JR3XNW/pico-SDR/BandScope_128x32/Wiring Diagram.jpg

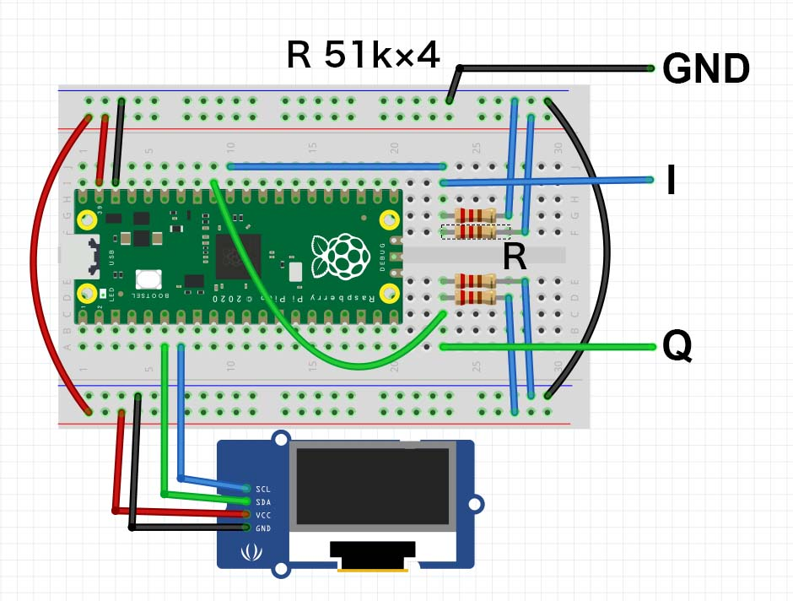
BandScope_128x32/Wiring Diagram.jpg
