JR3XNW/pico-SDR/uSDX/uSDX_1.02.jpg

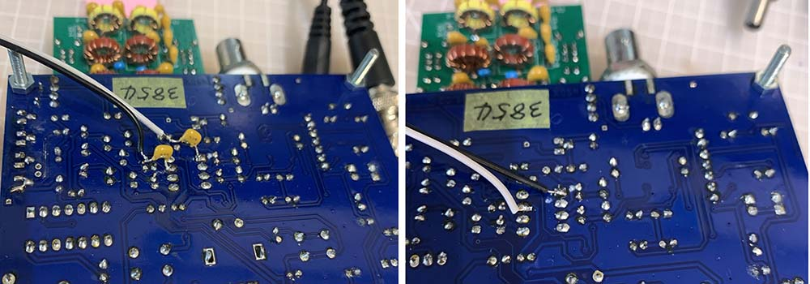
uSDX/uSDX_1.02.jpg
