JR3XNW/pico-SDR/BandScope_128x32/BlockDiagram.jpg

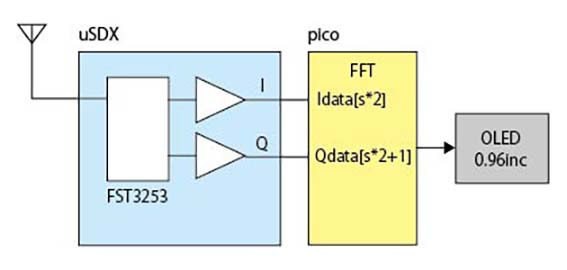
BandScope_128x32/BlockDiagram.jpg
