JR3XNW/pico-SDR/BandScope_128x32/pico_BandScope_128x32_circuit.jpg

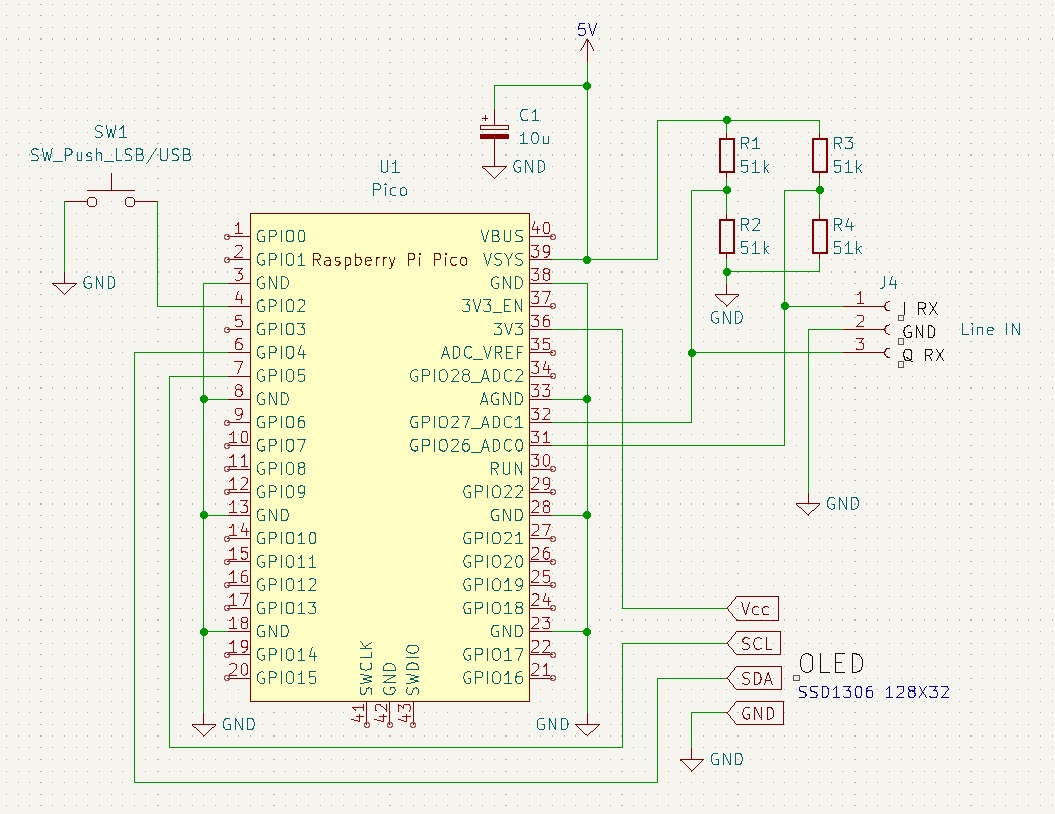
BandScope_128x32/pico_BandScope_128x32_circuit.jpg
