JR3XNW/pico-SDR/BandScope_WaterFal128x64/pico_FFT_circuit.jpg

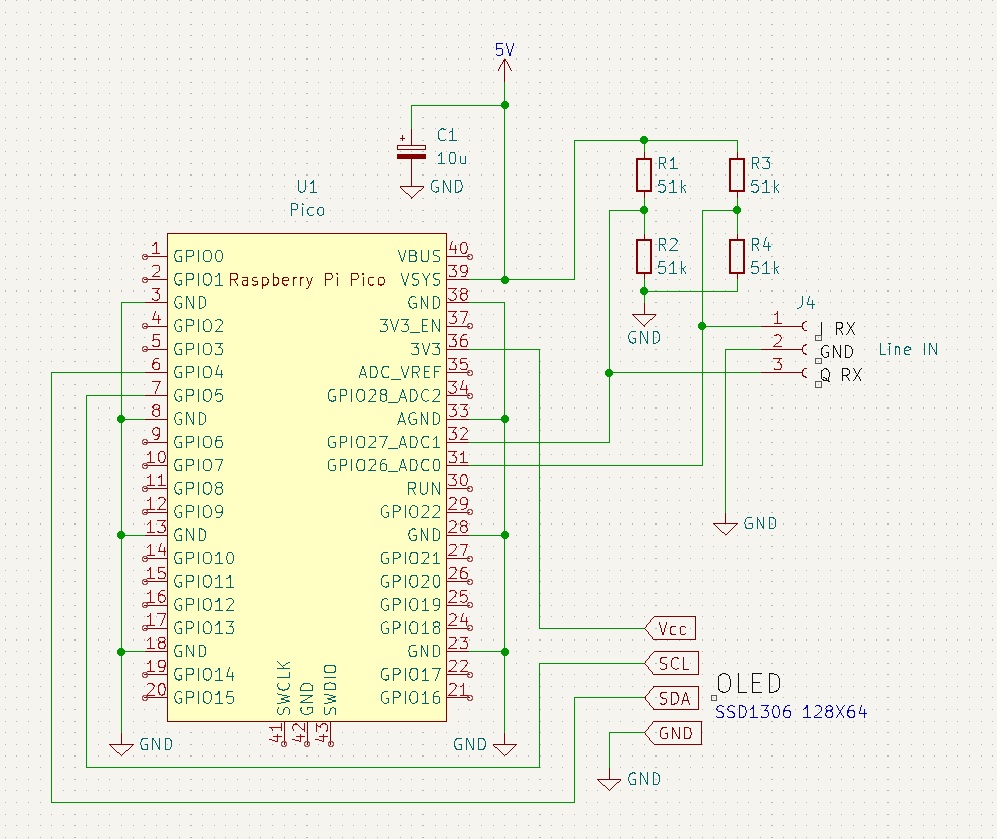
BandScope_WaterFal128x64/pico_FFT_circuit.jpg
