JR3XNW/pico-SDR/pico40M_monoband_radio/MixerCircuit.jpg

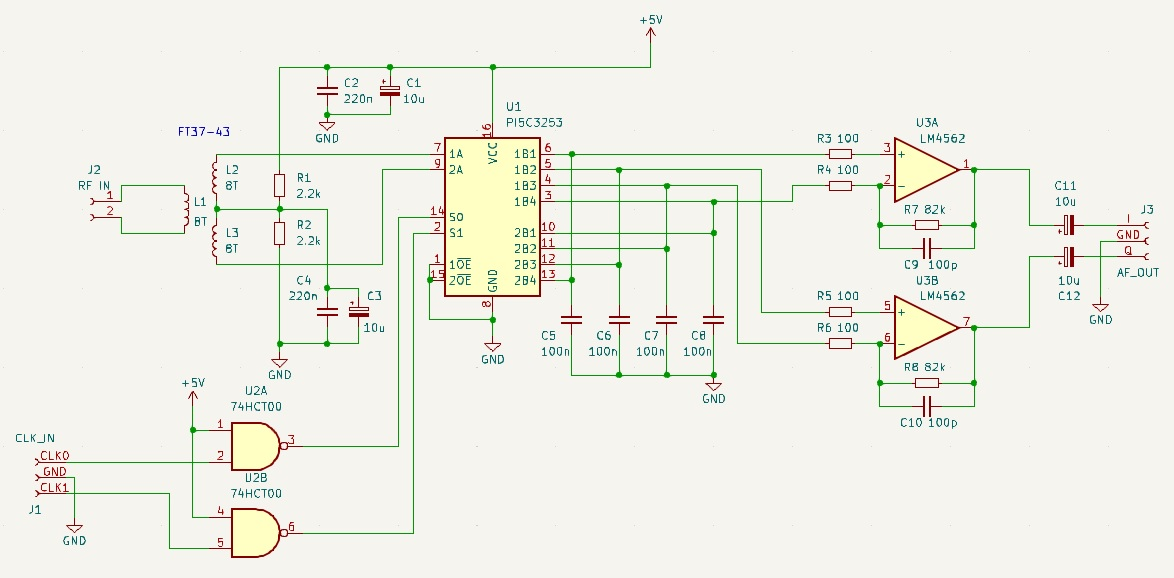
pico40M_monoband_radio/MixerCircuit.jpg
