JR3XNW/pico-SDR/pico40M_monoband_radio/pico_SDR.jpg

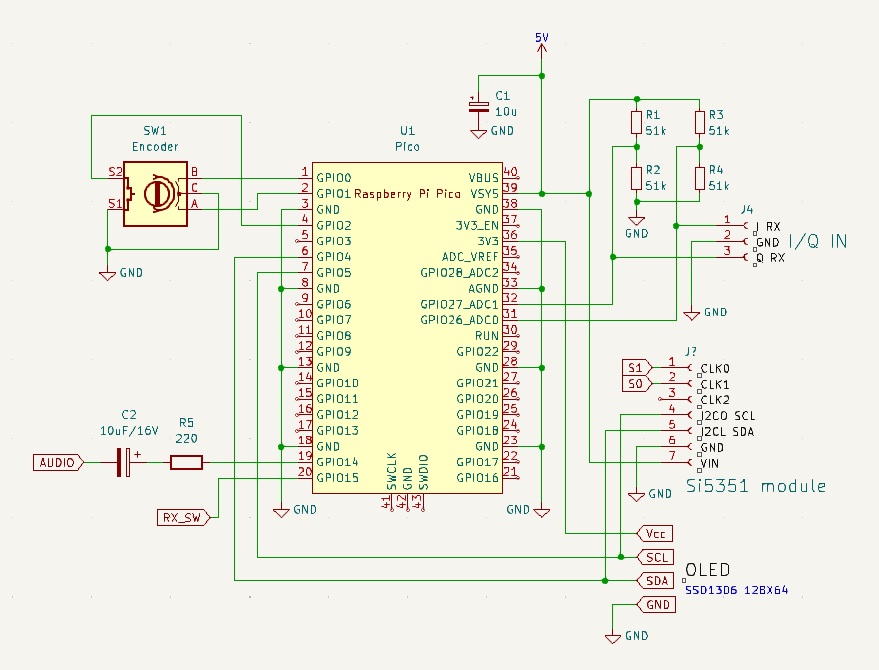
pico40M_monoband_radio/pico_SDR.jpg
