JR3XNW/pico-SDR/pico40M_monoband_uSDX/Atmega328_to_pico.jpg

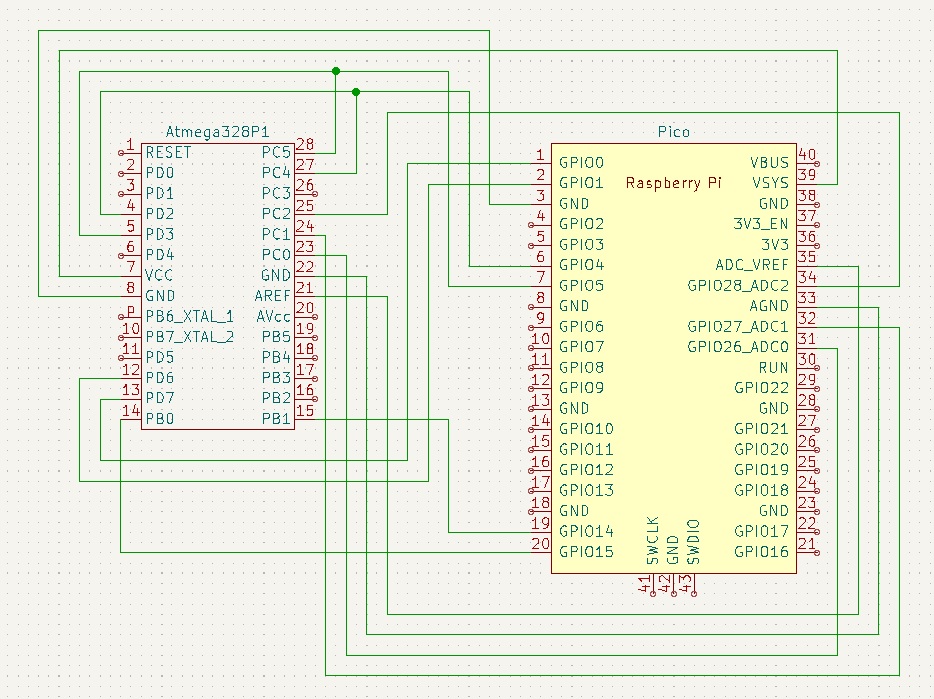
pico40M_monoband_uSDX/Atmega328_to_pico.jpg
