JR3XNW/pico-SDR/pico40M_monoband_uSDX/change_sketches.jpg

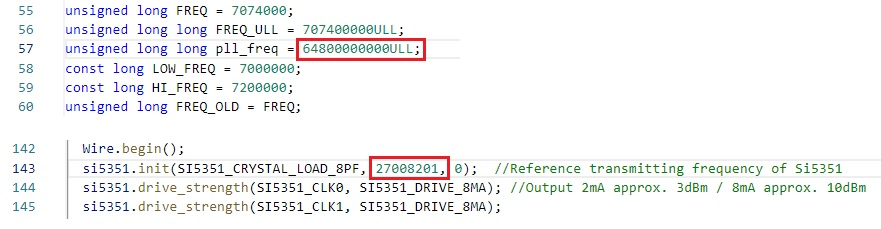
pico40M_monoband_uSDX/change_sketches.jpg
