JR3XNW/pico-SDR/pico40M_monoband_uSDX/image6.jpeg

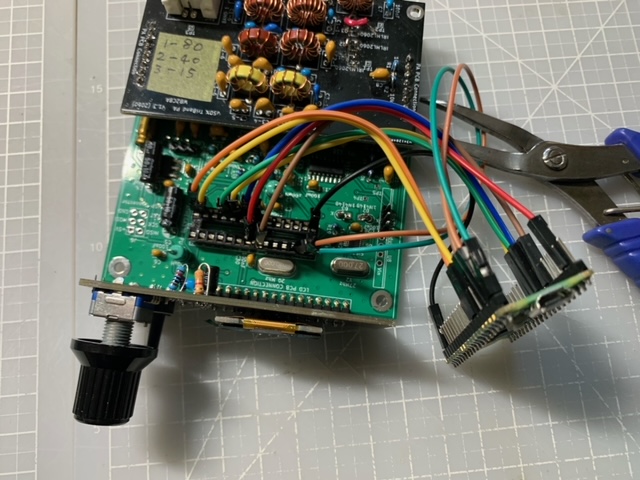
pico40M_monoband_uSDX/image6.jpeg
