JR3XNW/pico-SDR/pico40M_monoband_uSDX/uSDX_TriBand.jpg

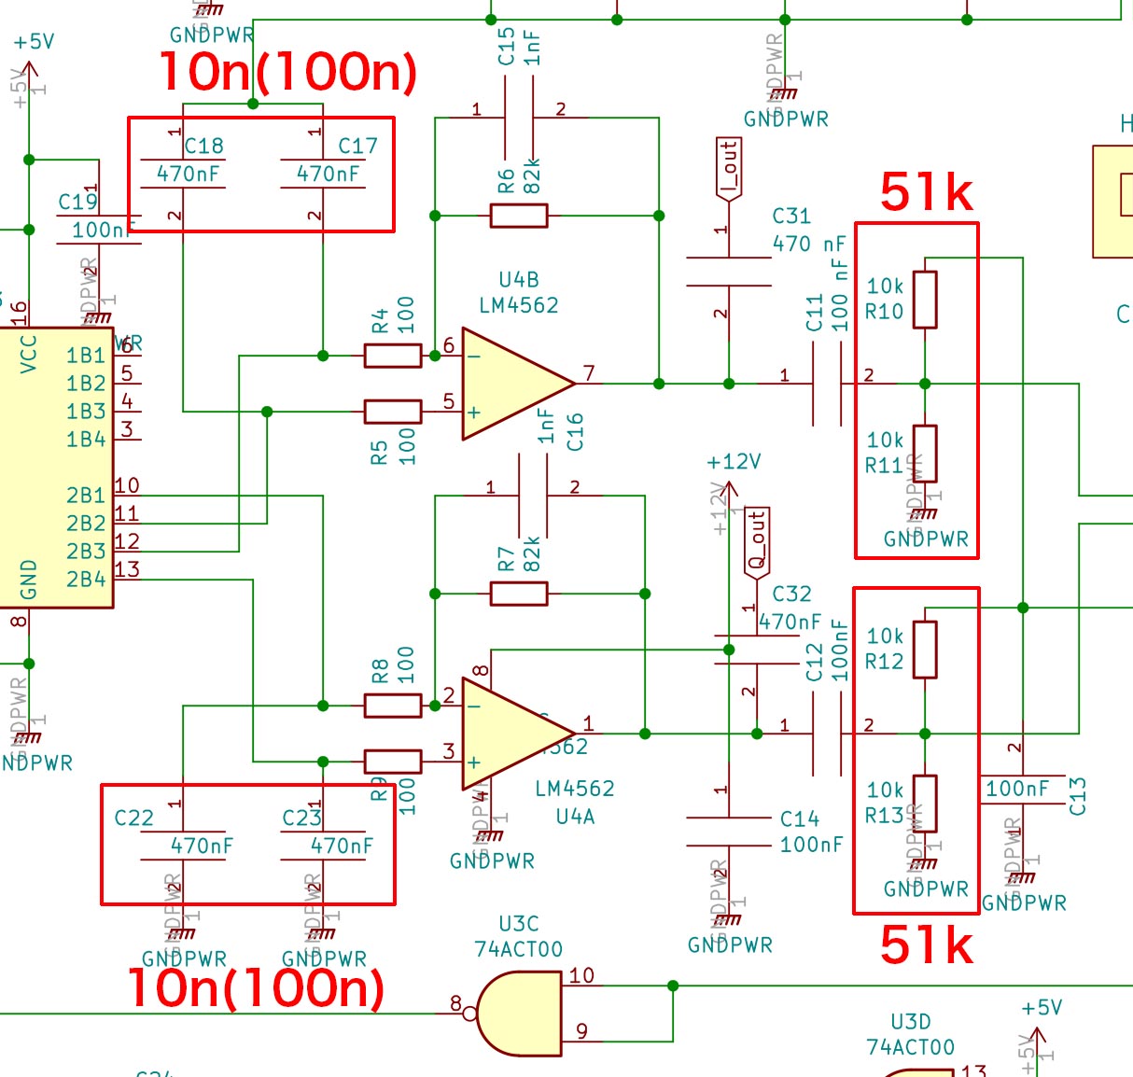
pico40M_monoband_uSDX/uSDX_TriBand.jpg
