JR3XNW/pico-SDR/Seeed_XIAO_RP2040_SDR_Radio/circuit.jpg

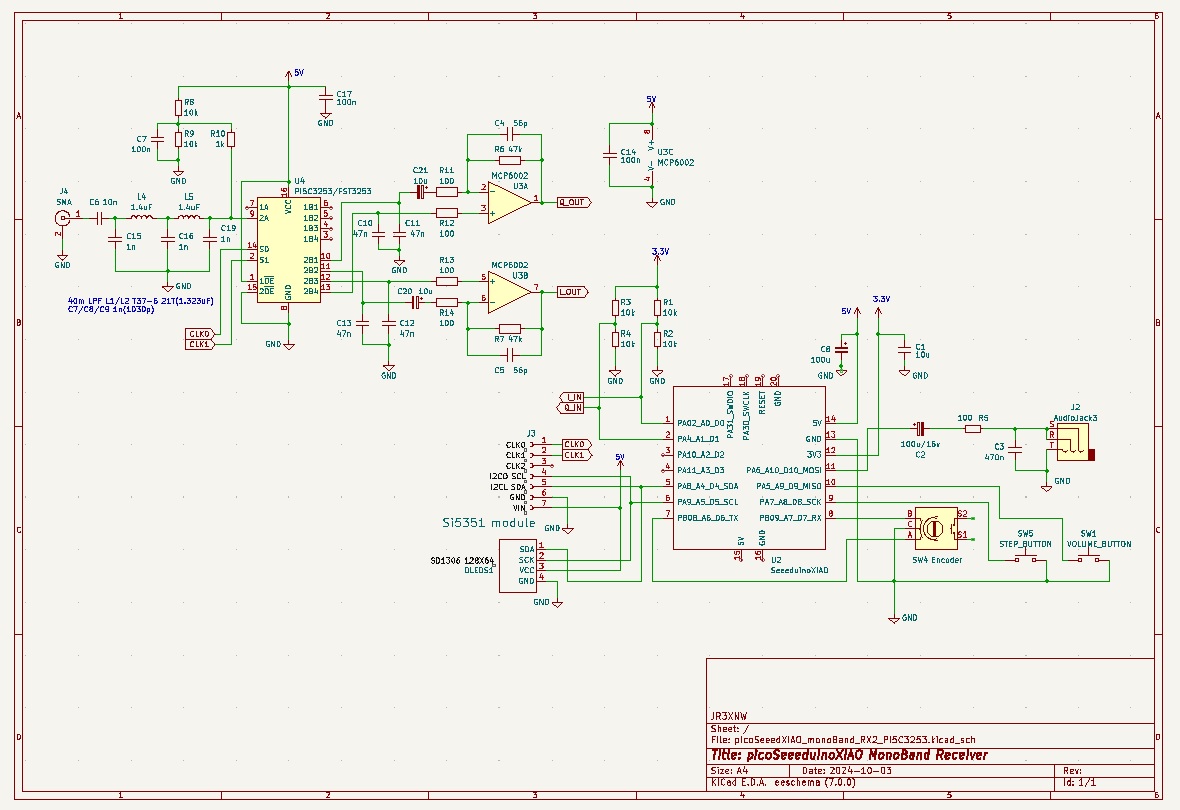
Seeed_XIAO_RP2040_SDR_Radio/circuit.jpg
