JR3XNW/pico-SDR/uSDX/uSDX_TriBand.jpg

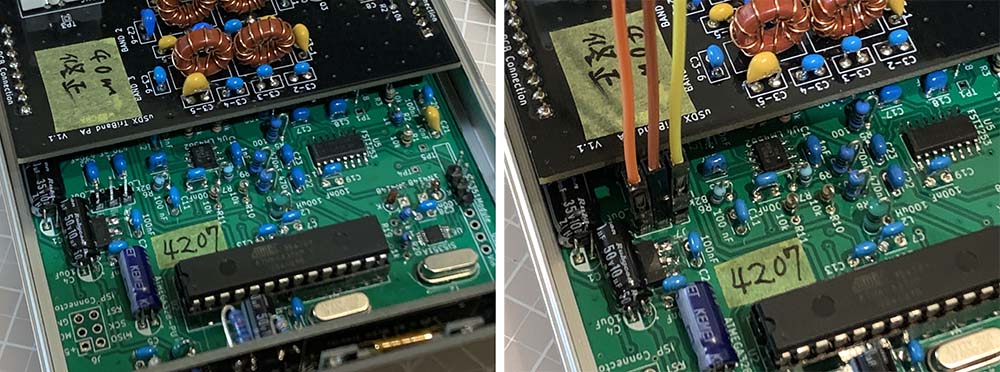
uSDX/uSDX_TriBand.jpg
