JR3XNW/pico-SDR/VFO_BandScope/pico_uSDX_VFO_BandScrope.jpeg

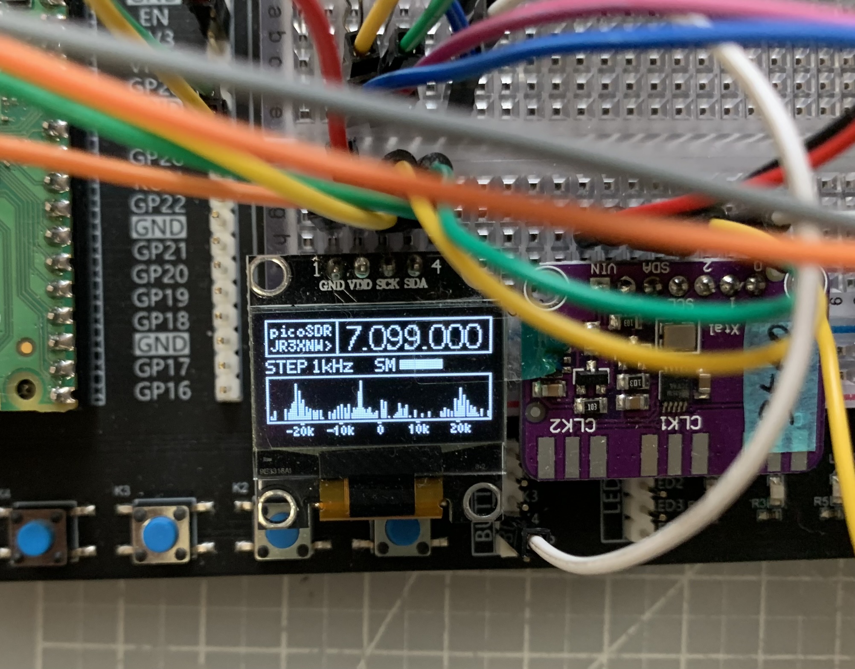
VFO_BandScope/pico_uSDX_VFO_BandScrope.jpeg
