JR3XNW/pico-SDR/VFO_BandScope/pico_uSDX_VFO_FFT_04_24.jpg

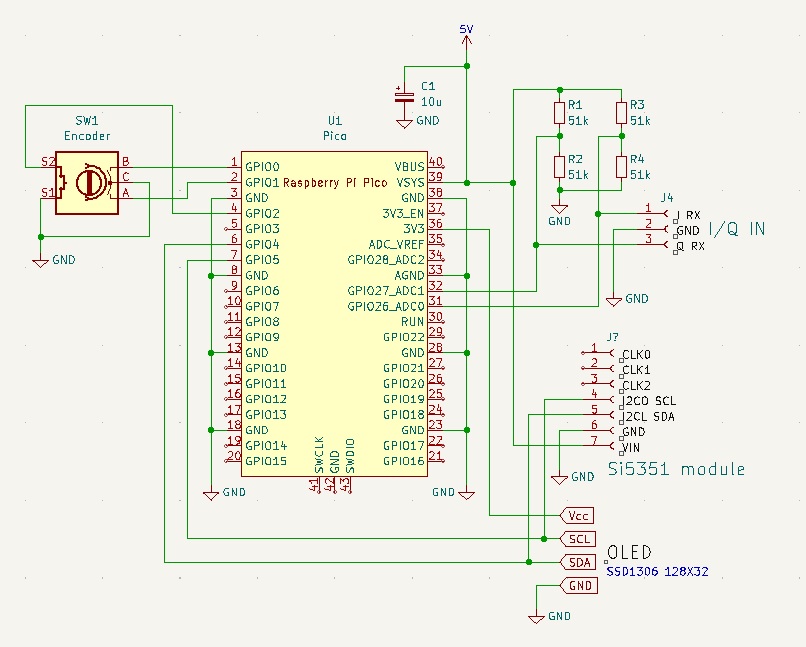
VFO_BandScope/pico_uSDX_VFO_FFT_04_24.jpg
