JR3XNW/pico-SDR/pico_RX/pico_uSDX_RX_test.jpg

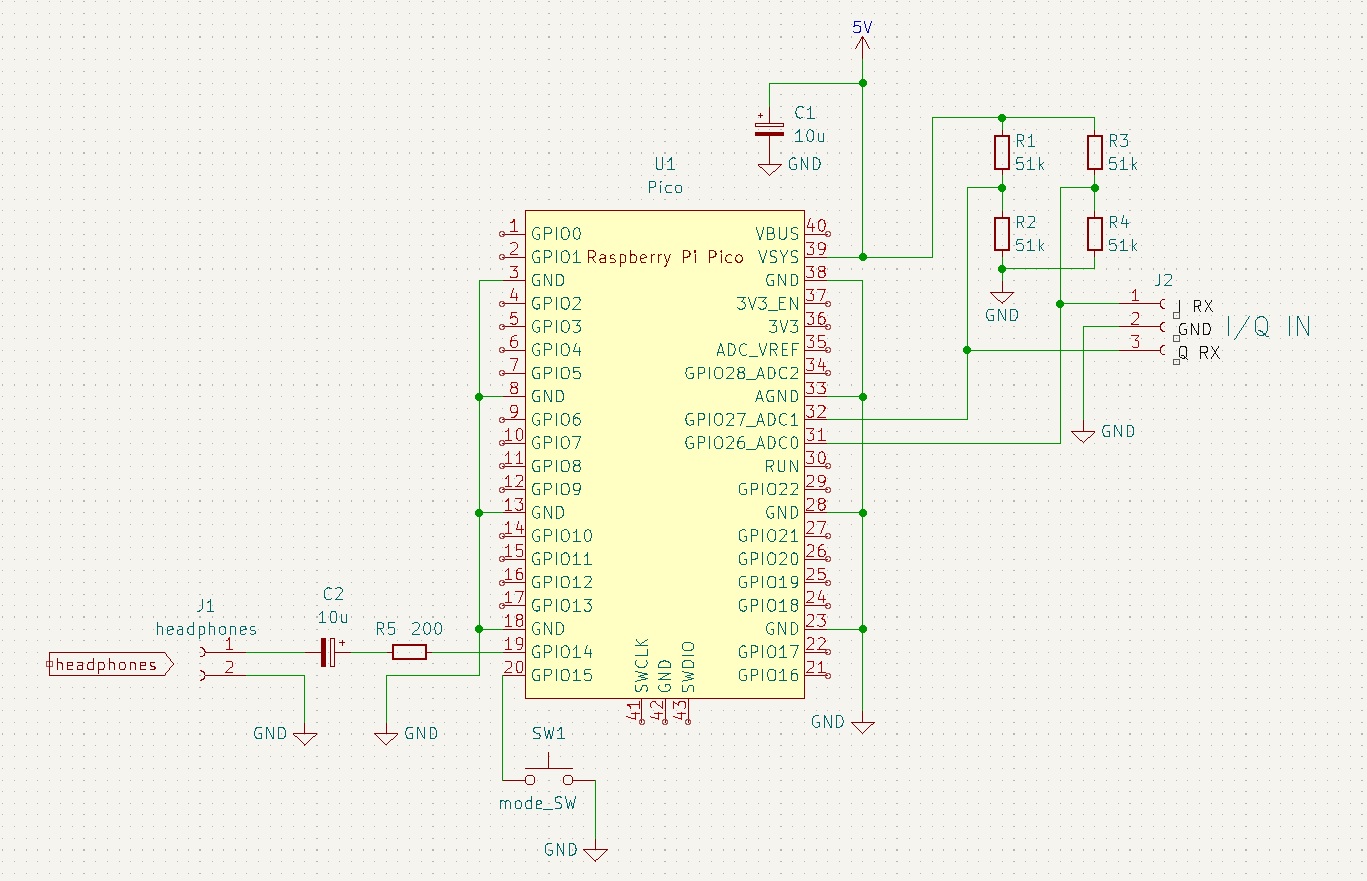
pico_RX/pico_uSDX_RX_test.jpg
