JR3XNW/pico-SDR/Seeed_XIAO_RP2040_SDR_Radio/picoSeeedXIAO_monoBandRX.pdf

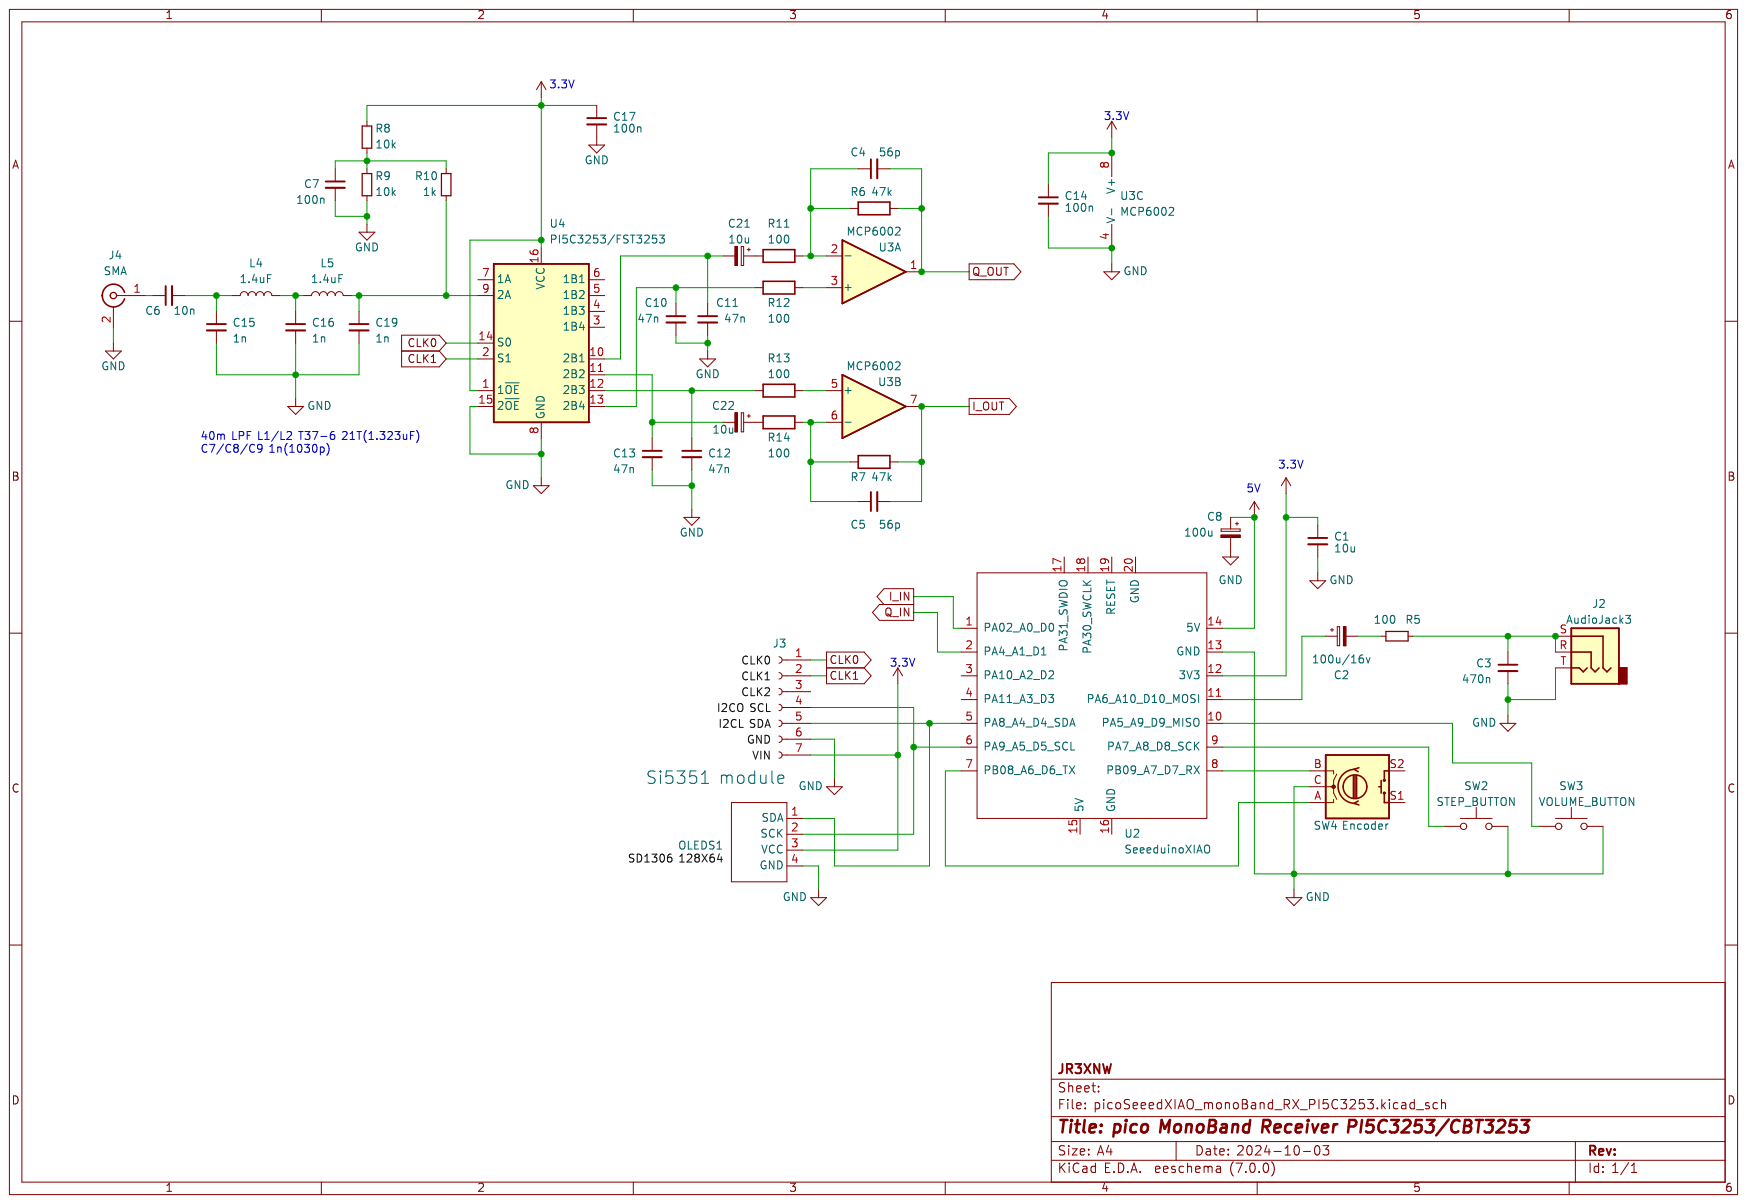
[picture p18: page 1]
