JR3XNW/pico-SDR/pico_SDR_Radio_V2_2/pico_monoband_40mRX.pdf

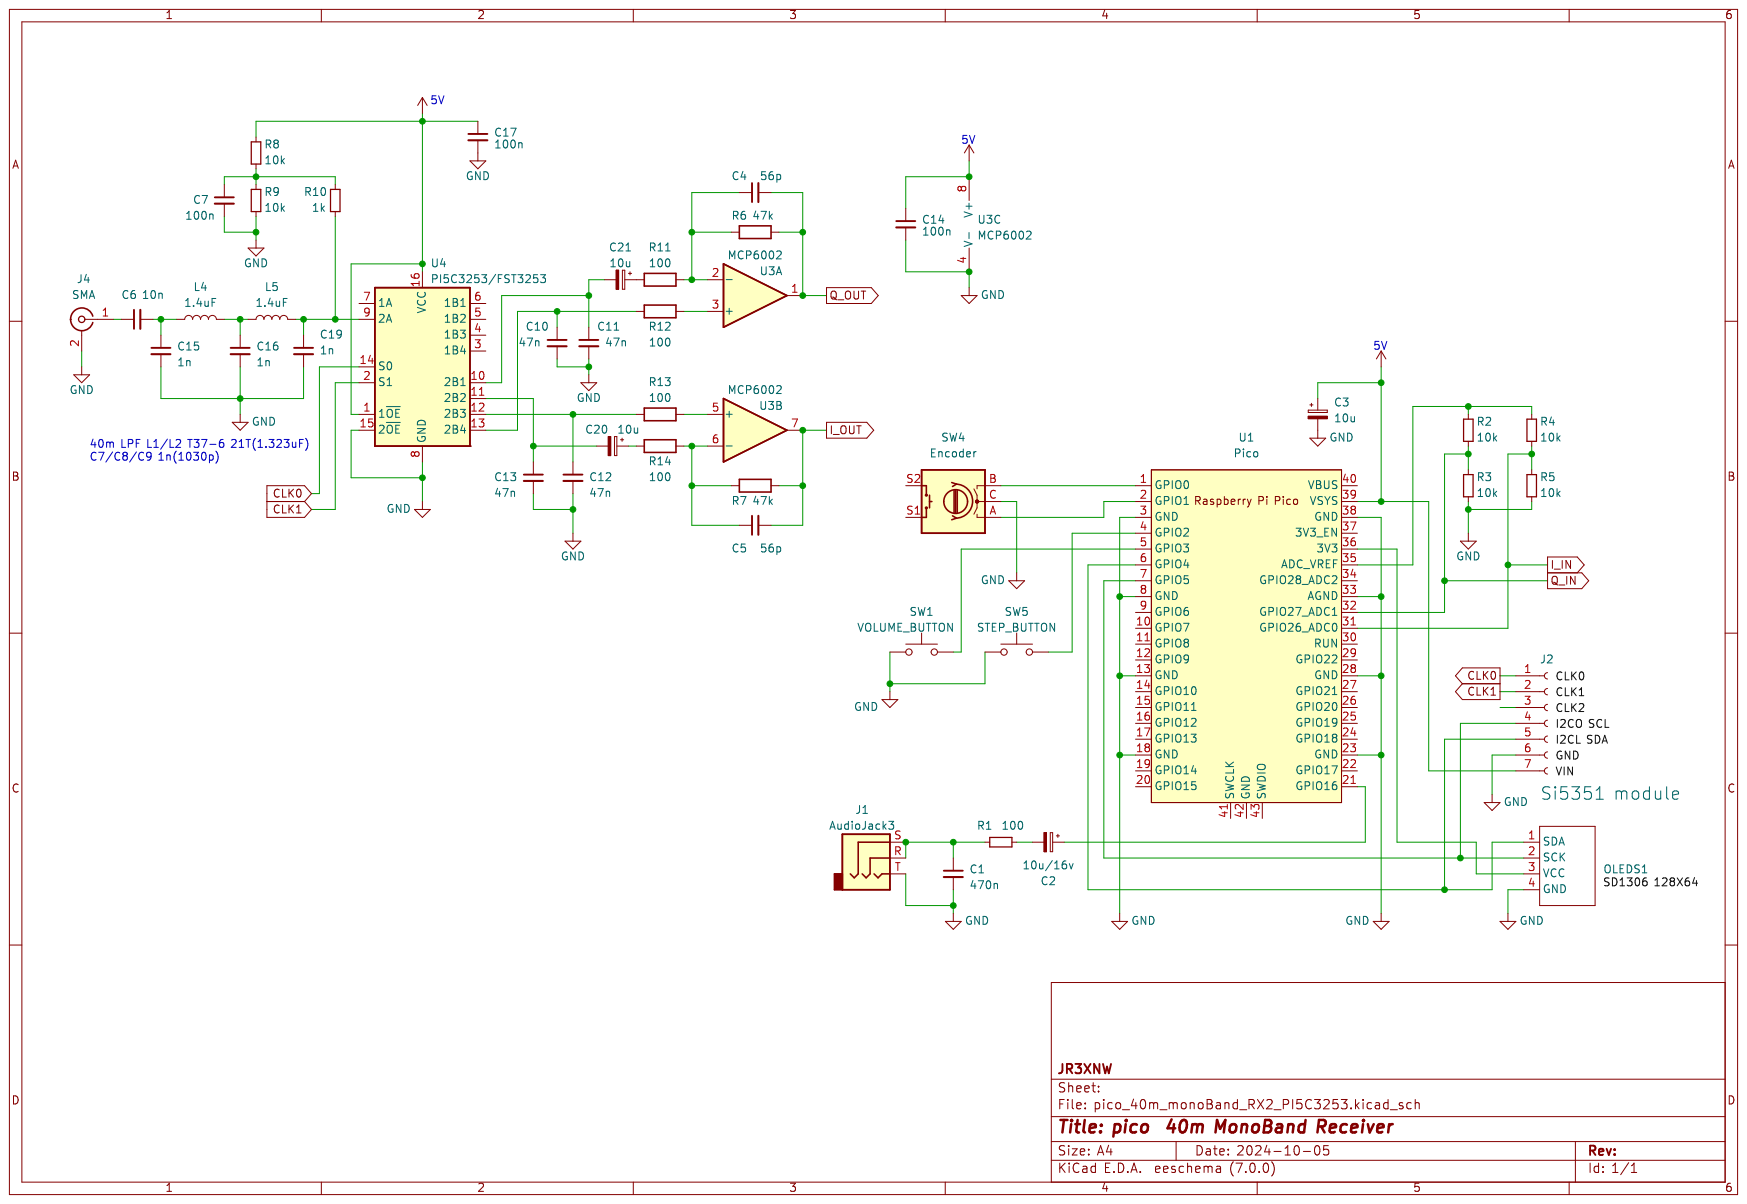
[picture p19: page 1]
